hetyus/bORG/docs/bORG_v1.2.1_detailed_schematic_EasyEDA.pdf

## LED OCT- LED OCT+

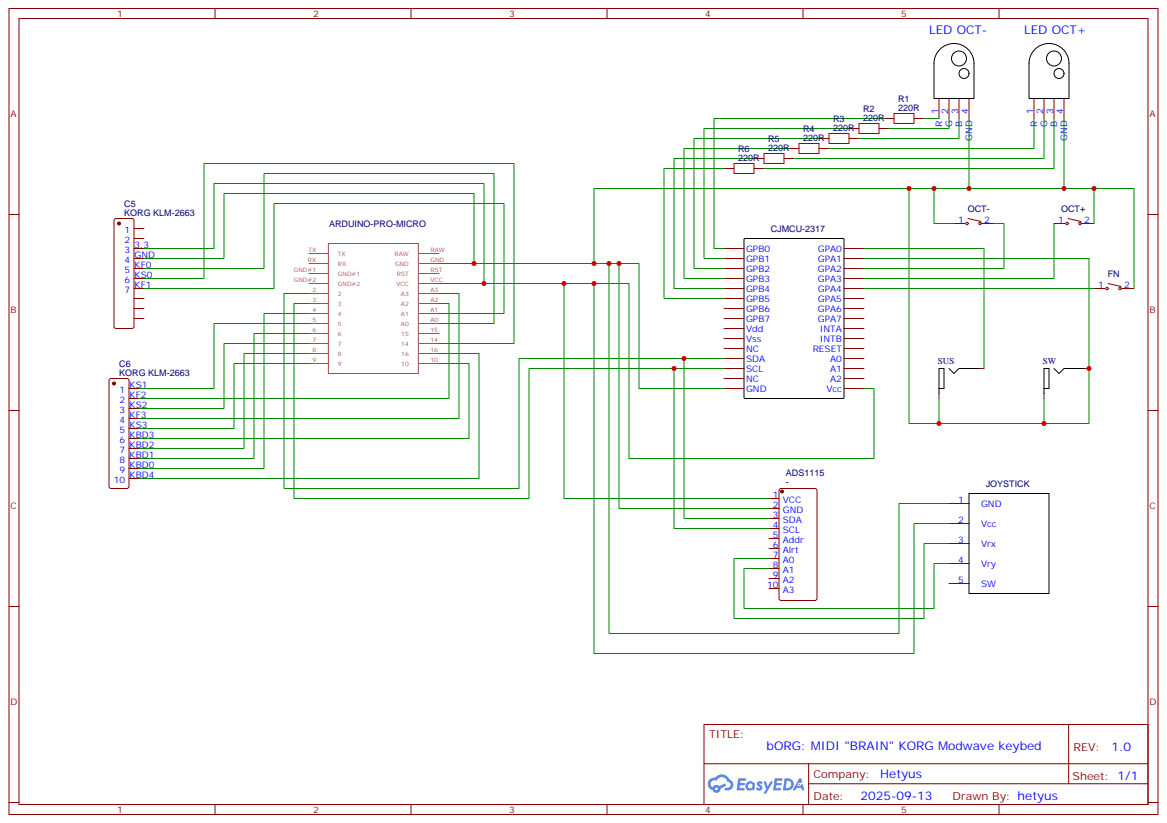
[picture p1: page 1]
